Parakoos/player-screen-holder/images/Closed Token Holder with Lid.jpg

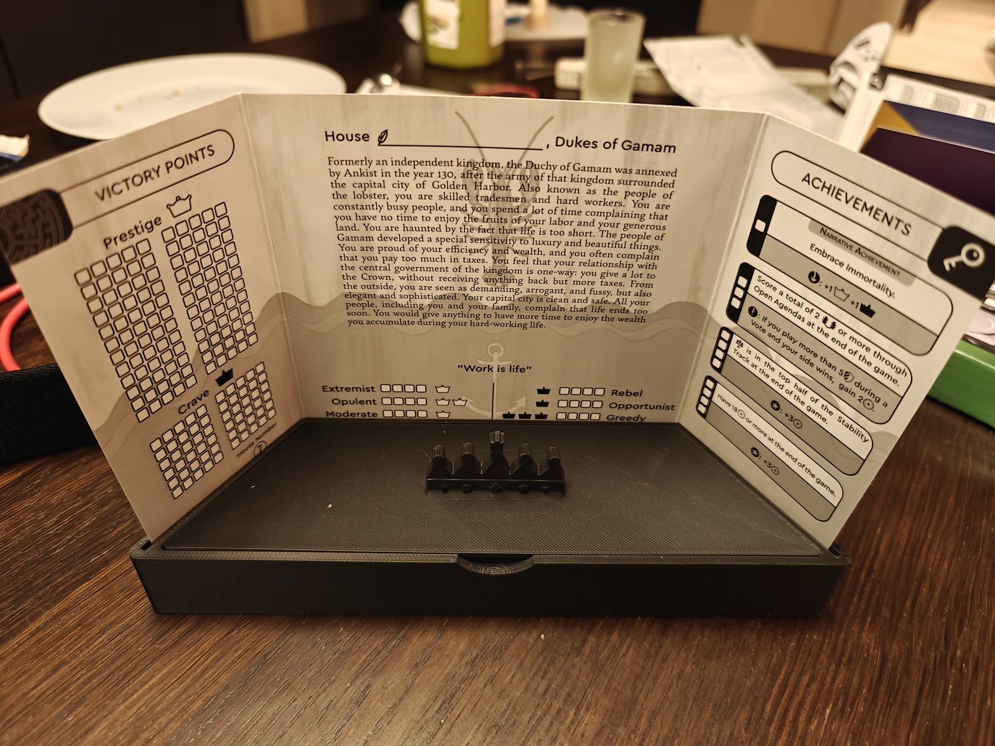
images/Closed Token Holder with Lid.jpg
