Parakoos/player-screen-holder/images/Closed Token Holder.jpg

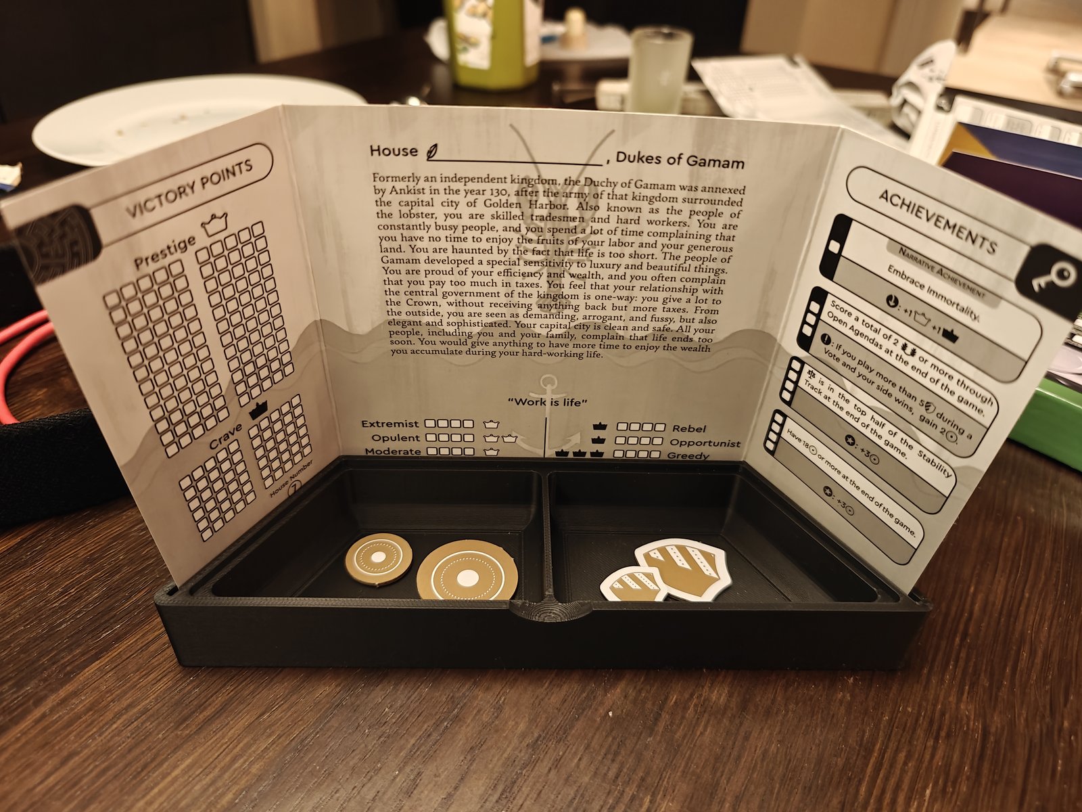
images/Closed Token Holder.jpg
