Parakoos/player-screen-holder/images/Open Token Holder.jpg

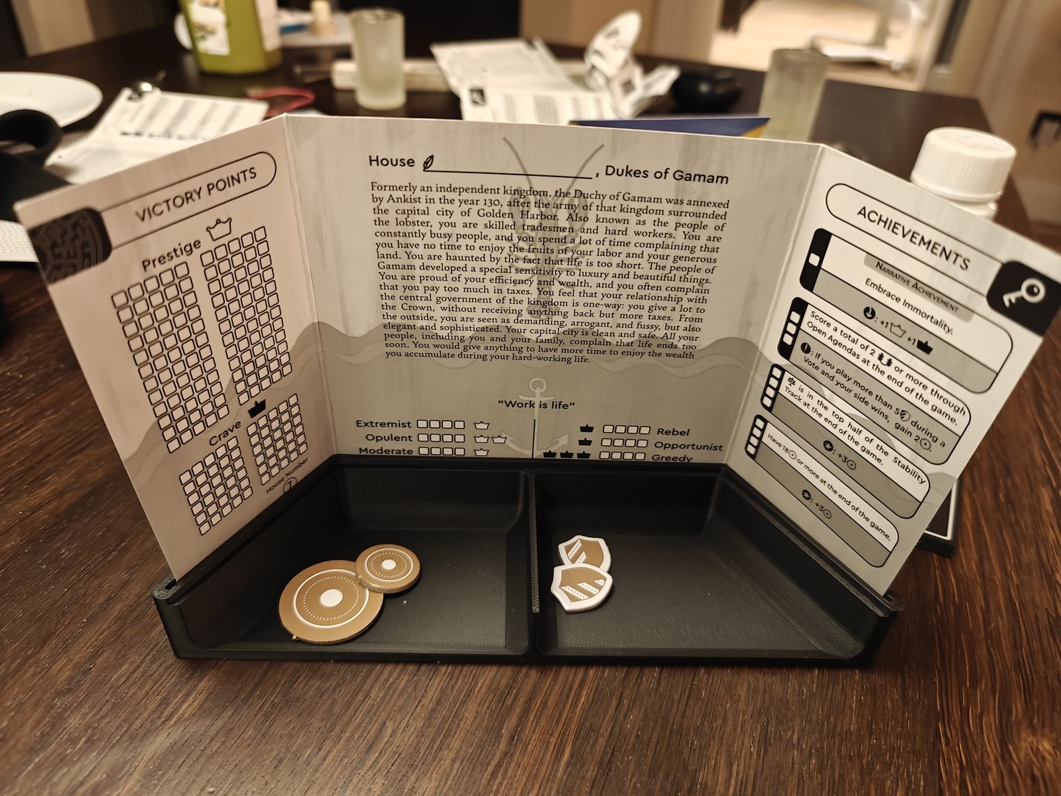
images/Open Token Holder.jpg
