Parakoos/player-screen-holder/templates/name-plates.3mf

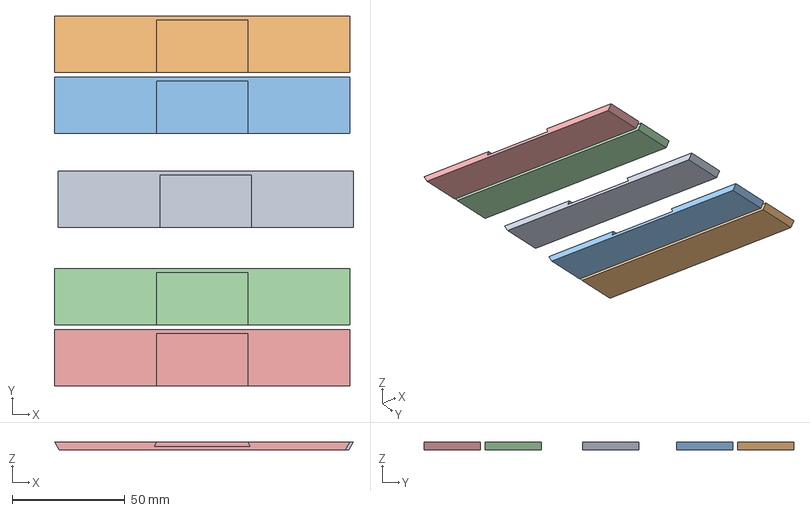
[picture p6: CAD file, 2026-10-20]
templates/name-plates.3mf
132.4 x 163.7 x 3.60 mm
delirea
adderbite
prunier
rambam
wulfric
