Parakoos/player-screen-holder/templates/bases.3mf

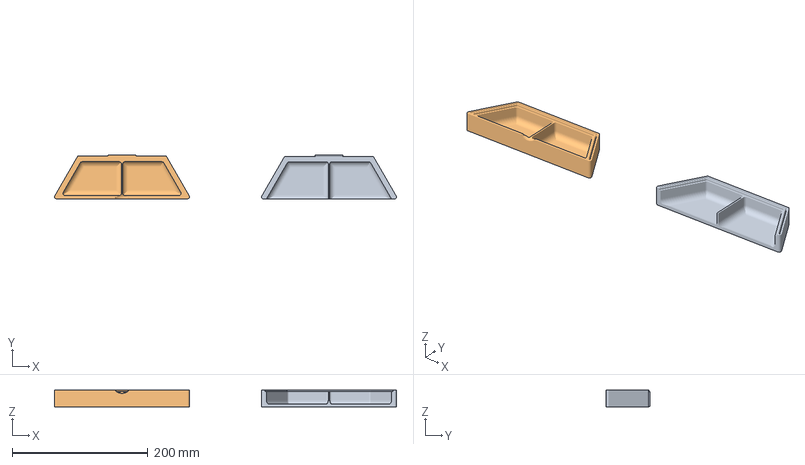
[picture p7: CAD file, 2026-10-20]
templates/bases.3mf
504.5 x 65.0 x 25.0 mm
Base, Open Front
Base, Closed Front
