Parakoos/player-screen-holder/templates/lids.3mf

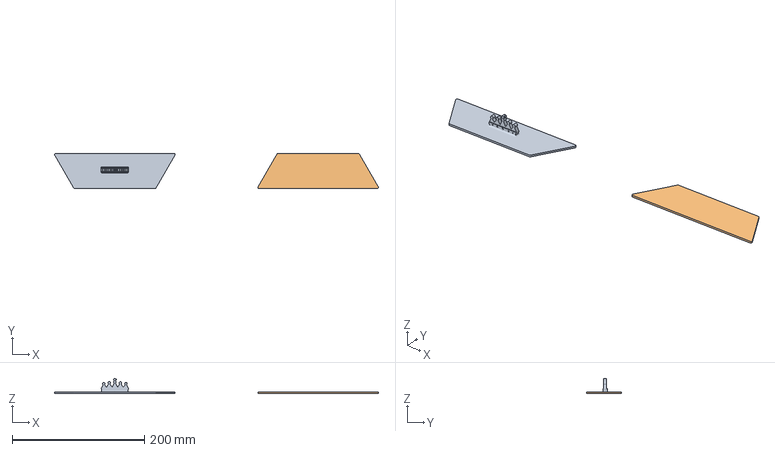
[picture p8: CAD file, 2026-10-20]
templates/lids.3mf
489.5 x 53.3 x 22.8 mm
Lid Crown (for Closed Front base)
Lid No Handle (for Closed Front base)
